jovanajanjatovic/Haos-u-Cua-oscilatoru/Work diary/jednacine_stanja_kola.png

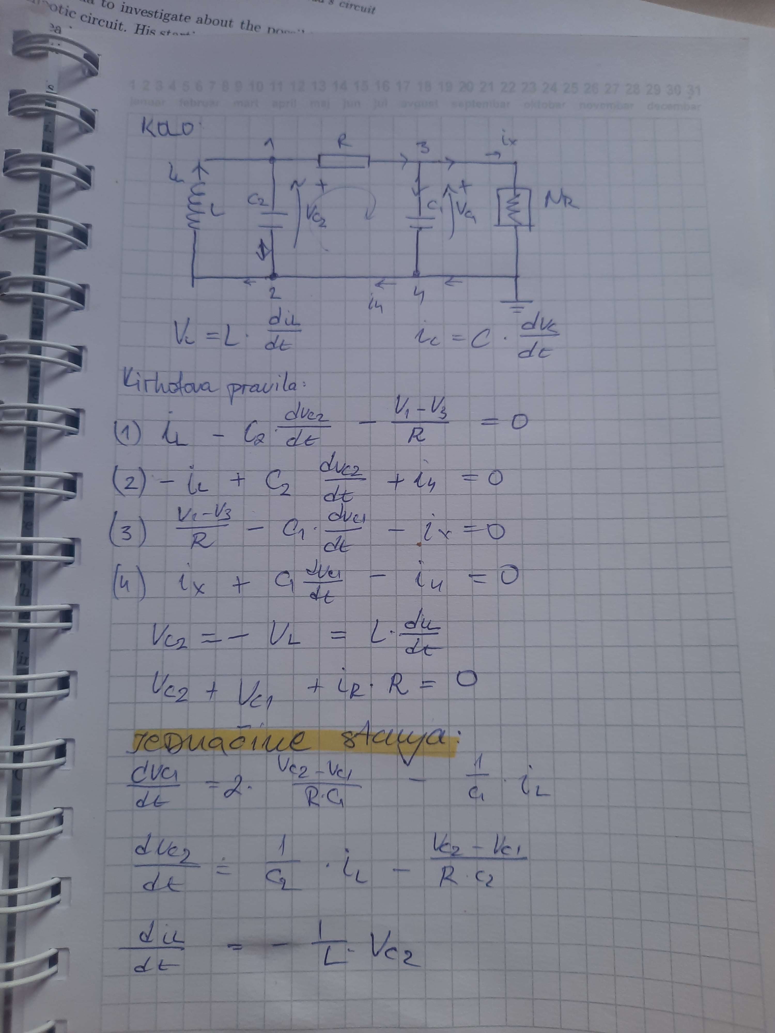
Work diary/jednacine_stanja_kola.png
