jovanajanjatovic/Haos-u-Cua-oscilatoru/README.md

# Haos-u-Čua-oscilatoru
Projekat rađen u Istraživačkoj stanici Petnica, na seminaru elektronike. Ciklus seminara 2023. godine. 
Cilj projekta je simulacija i sinhronizacija haosa u Čua oscilatoru. Na zimskom seminaru, konstruisano je  Čua kolo na protobordu i u LTspice-u (Čua dioda je realizovana na dva načina) i uveriti se da haos postoji. Sledeći korak je dizaj PCB ploče u Altium-u i slanje iste na proizvodnju. Zatim, plan je da napravim simulaciju sa mogućnošću menjanja parametara u MATLAB-u, Simulink. Zatim, sinhronizovati ploče (po principu Master i Slave Chua) i naći primenu tako sinhronizovanog haosa. Postoji nekoliko opcija: šifrovanje biomedicinske slike sa memristorom, neuromuskularna električna stimulacija poistovećenu haosom nastalim u Čua kolu (capacitor-switch model of excitatory and inhibitory neuron), simulacije nervnih impulsa tokom epileptičnog napada.

Postojanje haosa u nekom sistemu može da se utvrdi na tri načina:
<br>1. numerički
<br>2. eksperimentalno
<br>3. analitički
Neki od pokazatelja haosa u električnom kolu su: Fazni dijagrami i vremenski signali, bifurkacioni dijagram, autokorelaciona funkcija, spektar snage, Poenkareovi preseci, Ljapunovljevi eksponenti i efekat leptira, Necelobrojne dimenzije atraktora.

<br>šema kola 1 (koristeći 2 operaciona pojačivača za realizaciju Čua diode): 
<br>

<br>šema kola 2 (koristeći diode za realizaciju Čua diode): 
<br>


<br>
GIF haosa uočenom na digitalnom osciloskopu:
<br>

cua_haos_10

<br>

cua_haos
