jovanajanjatovic/Haos-u-Cua-oscilatoru/Istraživanje haosa u Čua oscilatoru.docx

Istraživanje haosa u Čua oscilatoru

# J. Janjatović

Sadržaj – U radu je analizirana pojava haosa u Čua oscilatoru. Postojanje haosa dokazano je kvalitativnim, kvantitativnim i eksperimentalnim pokazateljima determinističkog haosa.Ovim radom objašnjeno je ponašanje haosa u najjednostavnijem kolu koje je potrebno za stvaranje istog, a korišćene metode se mogu koristiti i za proučavanje haosa u složenijim električnim sistemima. Haotična kola, poput ovog primenu nalaze u širokom spektru, od medicinskih istraživanja, do muzike i šifrovanja.

I. Uvod

Haos (reč potiče od starogrčke reči χάος) je neuređeno ili iregularno menjanje stanja nekog sistema. Razlikujemo dve vrste haosa: deterministički haos (javlja se u sistemima koji su matematički determinisani) i nedeterministički haos (javlja se u sistemima koji nisu potpuno matematički određeni). Haos koji se javlja u električnim kolima svrstava se u deterministički haos.

Osnovna karakteristika svih haotičnih sistema jeste da su nelinearni.Takođe, da bise unutar sistema koji opisujemo mogla ispoljavati haotična svojstva, po teremi Poenkare-Bendiksona, neophodno je da su jednačine stanja tog kola opisane diferencijalnim jednačinama, najmanje drugog stepena ili sistemom od tri autonomne diferencijalne jednačine prvog reda. Ono što karakteriše sve haotične sisteme jeste osetljivost na početne uslove („efekat leptira“).

Oscilatori su

Haos u električnim kolima javlja se usled...

Da bi se haotično ponašanje ispoljilo u nekom električnom kolu, u kolu moraju postojati najmanje:

1. jedan nelinearni element
2. jedan ili više otpornika koji mogu imati negativnu vrednost
3. tri ili više elemenata za skladištenje energije

II. Opis kola

Čua oscilator predstavlja najjednostavnije električno kolo koje ispunjava sva tri uslova za postojanje haosa. Njega je konstruisao Leon Chua u proleće, 1983. godine. Ideja je nastala iz potrebe da se osmisli laboratorijski sistem koji u realnosti može zadovoljiti Lorencove jednačine. Pored kompjuterske simulacije, Leon Chua je eksperimentalno i matematički dokazao postojanje haotičnog ponašanja.

J. Janjatović, učenica četvrte godine Šabačke gimnazije. Polaznica Istraživačke stanice Petnica, seminara elektronike. Masarikova 13, 15000 Šabac, Srbija. E-mail: jovana.janjatovic.05@gmail.com

## A. Šema kola - Čua oscilator

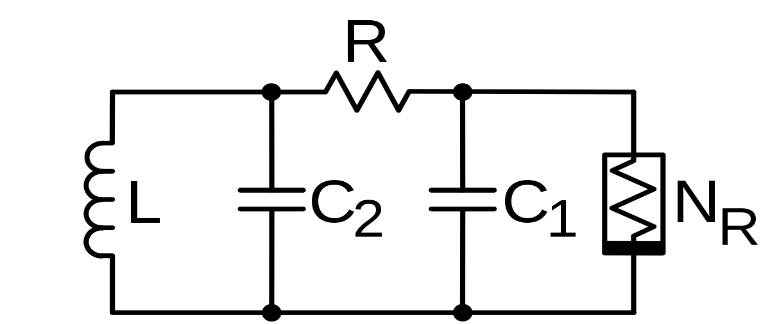
[picture p2: figure]
Chua's circuit - Wikipedia

Slika 1. Šema Čua oscilatora

Na slici 1. uočavamo od čega se sastoji električno kolo. Elementi označeni sa C1 i C2 predstavljaju kondenzatore, R je promenljiv otpor, L je induktivnost otpornika i NR je Čua dioda.

## B. Čua dioda

Čua dioda je nelinearan element u ovom kolu. To je zapravo nelinearan otpornik sa dva terminala i parcijalno linearnom strujno naponskom-karakteristikom koja se može videti na slici 2.Kada se posmatra sutrujno-naponska karakteristika nekih nelinearnih elemenata, ona se razdvaja na linearne segmente, pa se isti problem svodi na linearnu analizu. Tako u strujno-naponskoj karakteristici Čua diode možemo posmatrati tri linearna segmenta.

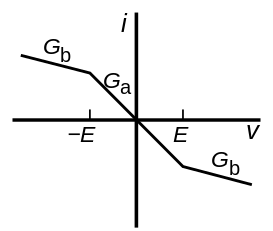
[picture p3: figure]

Slika 2. Strujno-naponsko karakteristika Čua diode

Struju koja prolazi kroz ovaj element, možemo napisati u funkciji od napona na njenim krajevima: iL= f(v1). Ta zavisnost prikazana je u formuli:

f(v1)={, m_1 x+ m_0 -m_1 , x>1 , m_0 x, -1≤x≤1 , m_1 x- m_0 + m_1 , x<-1 (1)

Gde je m0 = Ga/G, m1 = Gb/G, G = 1/R.

Postoji nekoliko načina realizacije Čua diode. Implementacija Čua diode korišćena ovog puta predstavljena je na slici 3. Ona se sastoji od dva operaciona pojačivača i šest linearnih otpornika.

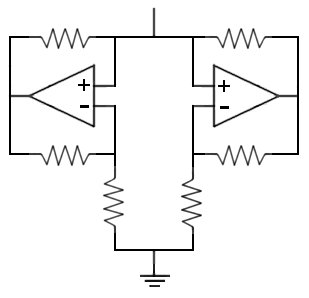
[picture p4: figure]
How to build Chua's circuit

Slika 3. Implementacija Čua diode

## C. Jednačine stanja kola

Jednačine stanja su jednačine kola po strujama kalemova i naponima kondenzatora, i pobudama, napisane u dogovorenom obliku (Košijeva normalna forma). U ovim jednačinama, sa leve strane je prvi izvod napona kondenzatora i struje kalema. Sa desne strane jednakosti su algebarski članovi struja kalemova i napona kodenzatora.

(dv1)/(dt)=2*(Vc2-Vc2)/(Rc1)- (iL)/(C1) (1)

(dv1)/(dt)= (iL)/(C2)-(Vc2-Vc1)/(Rc1) (2)

(diL)/(dt)= - (Vc2)/L (3)

Kada se uvedu smene, jednačine (1), (2) i (3), dobijaju sledeći oblik:

x = α(y−x−f(x)) (4)

y = x−y+z (5)

z = −βy (6)

Gde formula 4 opisuje promenu napona na kondenzatoru C1; αje parametar koji zavisi od odabira kapacitivnosti kondenzatora koji ulaze u kolo. Analogno, formula 5 opisuje promenu napona na kondenzatoru kapacitivnosti C2. Formula 6prestavlja promenu struje kalemova.

D. Iduktivni element u kolu

Prilikom postizanja precizne i stalne vrednosti induktivnosti kalema može se naići na problem. Zato, u ovom kolu umesto kalema, koristimo žirator, ondnosno kolo koje ima induktivnu osobinu. Prikaz ovog kola (nazivanog još i Antonio Inductance-Simulation Circuit) sa vrednostima komponenti vidi se na slici 4. Induktivnost ovog kola se dobija po formuli:

L = (C*R7*R9*R10)/(R8) (7)

Gde R10 zapravo predstavlja potenciometar (otpornik promenljive vrednosti) kako bi mogli da menjamo vrednost induktivnosti.

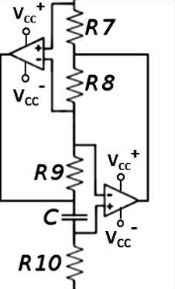
[picture p5: figure]

Slika 4. Antonio Inductance-Simulation Circuit

III. Fazni dijagrami

Figura u faznom prostoru po kojoj se „kreće“ sistem naziva se atraktor. Čudni atraktor, za razliku od običnih predstavlja geometrijski objekat koji ima fraktalnu dimenziju. Jedan od kriterijuma koji je neophodan da postoji kada definišemo sistem koji je ušao u haotično stanje, jeste da je dimenzija njegovog atraktora fraktalna (necelobrojna).

Za posmatranje signala koji se javlja oscilovanjem, koristi se merni uređaj osciloskop. Na X i Y osi prikazani su promenljive vrednosti napona na kondenzatorima C1 i C2. Zbog kašnjenja između trenutka merenja i prikaza, koje se javlja prilikom korišćenja digitalnog osciloskopa, za prikazivanje haosa u električnom kolu korišćen je analogni osciloskop.

IV. Proizvodnja štampane ploče

Štampana ploča (PCB – Printed Circuit Board), predstavlja elektronsku komponentu koja omogućava ostvarivanje veze među ostalim elektronskim komponentama koje su uključene u njen sastav. Glavna podela štampanih ploča je na jednoslojne i višeslojne.

Štampana ploča čija je izrada opisana u ovom odeljku je jednoslojna. Ona sadrži komponente poređane sa jedne strane, a rute kojima su one povezane sa druge. Program koji je korišćen za dizajniranje ploče je Proteus 8.9 Professional.

A. Šema štampane ploče

Dizajn štampane ploče počinje od šematskog prikaza kola (slika 5), sa definisanim vrenostima komonenti (tabela 1).

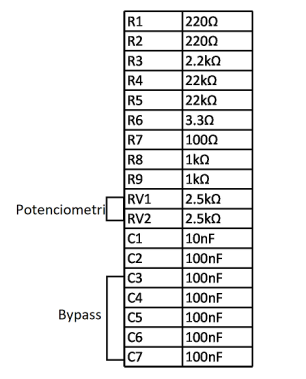
[picture p6: figure]

Tabela 1. Tabela vrednosti

IV. Zaključak

Čua kolo je jedno od najlopularnijih dinamičkih sistema korišćenih za istraživanje dinamičkih ponašanja u svim stanjima: periodičnom, kvaziperiodičnom i haotičnom.

Zahvalnica

Zahvaljujem se svom mentoru Stevanu Goluboviću koji mi je od samog početka projekta davao smernice za rad, upućivao na potrebnu literaturu i pomogao u prevazilaženju prepreka na koje sam nailazila. Takođe, gggg

Literatura

[1] N. Stojadinovic, S. Djoric-Veljkovic, I. Manic, V. Davidovic, and S. Golubovic, “Effects of Elevated-Temperature Bias Stressing on Radiation Response in power VDMOSFETs”, in Proc. 8thInternational Symposium on the Physical & Failure Analysis of Integrated CircuitsIPFA 2001, Singapore, 2001, pp. 243-248.

[2] N. Ojkić, „Deterministički haos i analiza nekih nelinearnih sistema“, diplomski rad, Univerzitet u Novom Sadu: Prirodno -matematički fakultet – departman za fiziku, Novi sad, 2006.

[3] The Antoniou Inductance-Simulation Circuit Derivation

Valentin Siderskiy.

[4] S. Dimitrijev, Understanding the Semiconductor Devices, New York, Oxford: Oxford University Press, 2000.

[5] T. Grasser, V. Palankovski, G. Schrom, and S. Selberherr, “Hydrodynamic Mixed-Mode Simulation”, in Simulation of Semiconductor Processes and Devices, K. De Meyer and S. Biesemans, Eds., pp. 247-250, Wien, New York: Springer, 1998.
