jovanajanjatovic/Haos-u-Cua-oscilatoru/Simulations/tl082 kolo.asc

C1: cap; 10n
C2: cap; 100n
L1: ind; 18mH
pot: res; {x}; tol=5
R1: res; 220
R2: res; 220
R3: res; 2.2k
R4: res; 22k
R5: res; 22k
R6: res; 3.3k
U1: opamp2; TL082
U2: opamp2; TL082
V1: battery; 9
V2: battery; 9
Named nets: 0
.tran 0 10ms 0 1000n
.lib TL082.301
.step param x 1k 3k 20
