jovanajanjatovic/Haos-u-Cua-oscilatoru/Simulations/diode_chua.asc

C1: cap; 100n
C2: cap; 4.7n
D1: diode; 1N4148
D2: diode; 1N4148
L1: ind; 4mH
R1: res; 1.13k
R2: res; 3.3k
R3: res; 3.3k
R4: res; 330
R5: res; 1k
R6: res; 330
R7: res; 5
R8: res; 47k
R9: res; 47k
U1: opamp2; TL082
V1: voltage; 9
V2: voltage; 9
Named nets: vcc, vee, 0
.tran 0 1 0 1u
.lib C:\\Users\\Jovana\\Desktop\\TL082.301
