jovanajanjatovic/Haos-u-Cua-oscilatoru/(list of files, drawings)

Other design files:
Chua kolo.pdsprj
